eswai/RS-G_SpeakerMount/speaker.jpeg

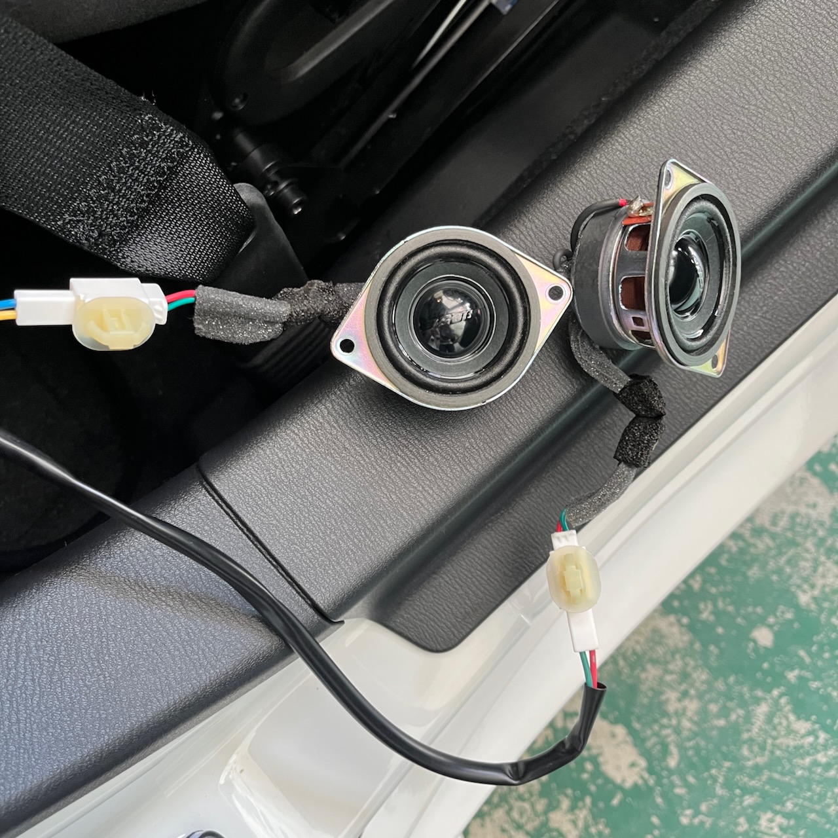
speaker.jpeg
