eswai/RS-G_SpeakerMount/Housing_R.stl

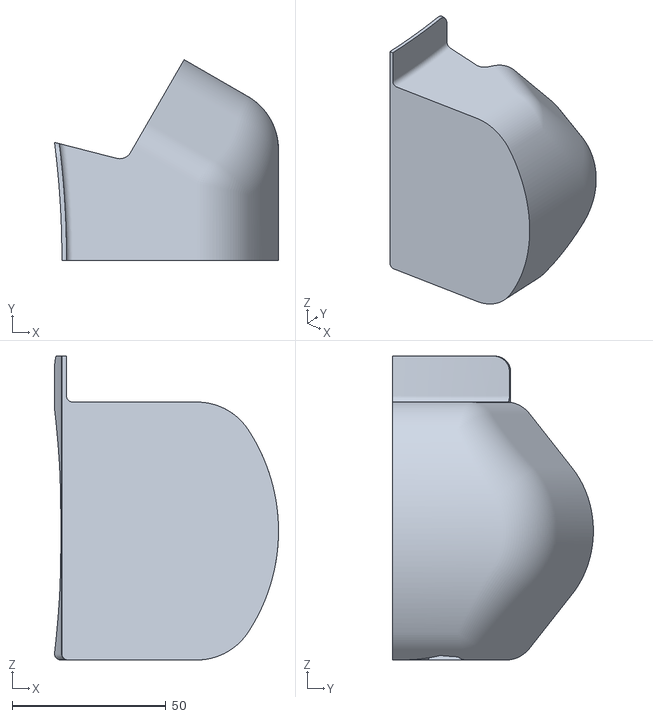
[picture p7: CAD file, 2022-09-04]
Housing_R.stl
73.0 x 65.4 x 99.0
