eswai/RS-G_SpeakerMount/Cover.stl

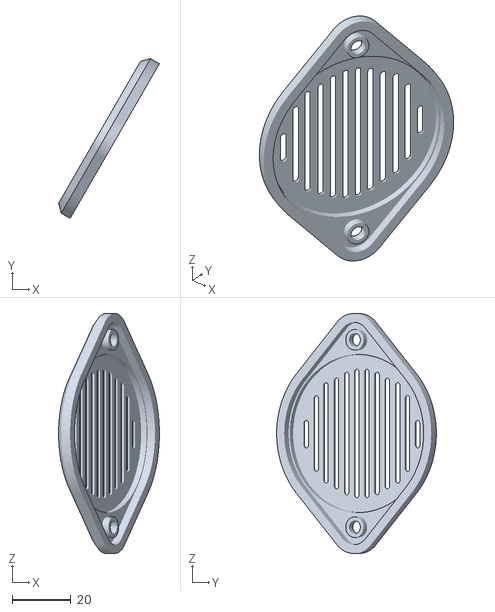
[picture p8: CAD file, 2022-09-04]
Cover.stl
34.4 x 54.6 x 82.0
