eswai/RS-G_SpeakerMount/RS-G_Headrest_Speaker Mount.step

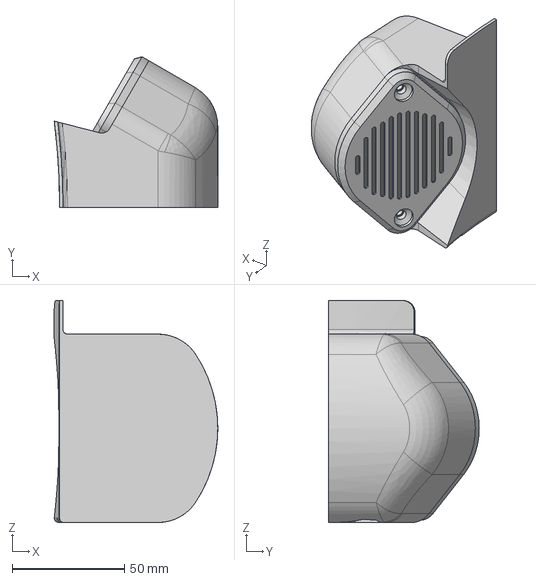
[picture p9: CAD file, 2022-09-04]
RS-G_Headrest_Speaker Mount.step
73.0 x 67.1 x 99.0 mm
