eswai/RS-G_SpeakerMount/(list of files, cad)

Other CAD files:
Housing_L.stl
RS-G_Headrest_Speaker Mount.f3d
